Field9527/ac880-fall-monitor/board_runtime/README.md

# AC880 摔倒监护与手势控制试运行

./run.sh 手动启动；./run.sh status 查看；./run.sh stop 安全停止。
run_home.sh 等同 run.sh；run_fall.sh 仅 HDMI。不开机自启。
OV5640 720p、PL 图像处理、DHT11 与 LED/蜂鸣器控制保留。
HDMI 顶部显示状态与评分，底部显示环境、手势及视频信息；报警采用红色边框，手机回放带有明确标记。
CPU 摔倒分支沿用 v6 权重；小型共享特征复核器判断手部、局部人体等。
张开手掌：全部开灯；握拳：全部关灯；V手势：短鸣0.5秒；停止鸣叫请用网页按钮。
单手完整入镜，保持手势至连续确认；保持不动只执行一次。网页可关闭手势控制。
手机回放模式暂停手势控制；网页手动控制始终可用。手部检测不能直接否决摔倒报警。
网页手机回放模式可手动设置输入方向；不会自动猜测重力方向。
重复回归通过不代表现场验收通过。原始训练数据和检查点不包含在运行包中。

## 拨码切换

SW0 是用户拨码开关第 0 位：向下（0）只运行摔倒识别，暂停手势；向上（1）只运行手势识别，暂停摔倒报警。切换时先消抖 150 毫秒，再排空旧任务并丢弃旧结果；LED 当前亮灭保持，旧报警或手势短鸣结束。环境采集、HDMI、视频与网页手动控制继续工作。不要改动启动方式选择开关。

本功能需要完整配套的 bit/hwh 与程序；接口缺失时识别保持暂停，并提示更新 FPGA 配置。HDMI 与网页均显示当前模式。手势模式不能用于同时监护摔倒，摔倒模式也不保证零误报。
