Field9527/ac880-fall-monitor/THIRD_PARTY_NOTICES.md

# 许可与来源

项目源码、供应商硬件代码、依赖库、模型和数据分别遵循对应文件中的版权、许可与使用条件。本仓库的公开展示不改变这些条件，不对全部内容统一重新授权。

| 组成 | 来源与条件 |
| --- | --- |
| NCNN | Tencent NCNN，BSD 3-Clause，完整声明见 `board_runtime/assets/licenses/ncnn-LICENSE.txt` |
| 掌部与关键点模型 | OpenCV Zoo，Apache-2.0；原始模型哈希见 `board_runtime/assets/models/gestures/source_manifest.json` |
| Fashion-MNIST | Zalando Research，MIT；声明见 `ac880_fall/ml/fashion-mnist-LICENSE.txt` |
| CAUCAFall v4 | DOI `10.17632/7w7fccy7ky.4`，CC BY 4.0 |
| UR Fall | 按作者说明采用 CC BY-NC-SA 4.0，用于非商业学术研究 |
| FreiHAND | 按其研究和非商业使用条件用于辅助区域监督，不包含原始图像 |
| 硬件模块 | 保留 RTL 文件中的供应商、作者及版权说明 |
| HDMI 字体 | DejaVu Sans 的 ASCII 子集，保留字体许可，见 `board_runtime/assets/licenses/DejaVu-LICENSE.txt` |

数据来源、划分边界和使用方式见 [数据来源记录](board_runtime/assets/DATA_SOURCES.md) 与 [训练说明](ac880_fall/ml/README.md)。原始数据集、相机原图和用户反馈画面不包含在仓库中。配套模型用于本项目研究与演示，使用时还应遵守相关模型及数据的条件。
