Field9527/ac880-fall-monitor/board_runtime/app/dual_inference.py

"""按识别模式处理最新帧，各最多一个在途任务。"""

from concurrent.futures import ThreadPoolExecutor
import os
from fall_lite import LatestFrameInference
from hand_region_review import review_hand_region


class ConcurrentGestureInference(LatestFrameInference):
    def __init__(self, detector, timeout_s=3.0, partition_cpus=False):
        self.owner_affinity = None
        cpus = []
        if partition_cpus and hasattr(os, "sched_getaffinity") and hasattr(os, "sched_setaffinity"):
            cpus = sorted(os.sched_getaffinity(0))
        if len(cpus) >= 2:
            self.owner_affinity = set(cpus)
            owner_cpu, hand_cpu = cpus[:2]
            # Linux 的 pid=0 仅设置当前线程。
            os.sched_setaffinity(0, {owner_cpu})
            super().__init__(
                detector, timeout_s, worker_initializer=lambda: os.sched_setaffinity(0, {owner_cpu})
            )
            self.hand_pool = ThreadPoolExecutor(
                max_workers=1, initializer=lambda: os.sched_setaffinity(0, {hand_cpu})
            )
        else:
            super().__init__(detector, timeout_s)
            self.hand_pool = ThreadPoolExecutor(max_workers=1)
        self.hand_future = None
        self.hand_submitted_at = None
        self.hand_completed = 0
        self.hand_observation = {}
        self.fall_epoch = self.hand_task_epoch = self.active_generation = None

    def poll(self, frame, now):
        # 空闲任务才取得自有快照，避免持有 DMA 视图。
        owned = []

        def source():
            if not owned:
                owned.append(frame() if callable(frame) else frame)
            return owned[0]

        options = self.detector.semantic_options.configuration
        generation = options["generation"]
        mode = options["recognition_mode"]
        fall_enabled = mode in ("both", "fall")
        enabled = mode in ("both", "gesture") and self.detector.gestures_enabled()
        if generation != self.active_generation:
            self.active_generation = generation
            self.hand_observation = {}
            self.observation = dict(
                ready=mode == "gesture",
                bbox=None,
                score=0.0,
                area=0,
                detections=[],
                objects=[],
                reviewed_candidates=[],
                fall_fresh=False,
                reason="model_mode_switch",
                semantic_generation=generation,
                monitor_mode=options["mode"],
            )
        fresh = False
        if self.future is not None:
            if self.future.done():
                observation = self.future.result()
                self.future = None
                self.completed += 1
                if fall_enabled and self.fall_epoch == generation:
                    observation.setdefault("source_monotonic", self.submitted_at)
                    self.observation = observation
                    fresh = True
                    self.fall_completed += int(observation.get("fall_fresh", True))
            elif now - self.submitted_at > self.timeout_s:
                raise TimeoutError("Fall inference exceeded %.1f seconds" % self.timeout_s)
        if self.hand_future is not None:
            if self.hand_future.done():
                hand = self.hand_future.result()
                self.hand_future = None
                if enabled and self.hand_task_epoch == (generation, options["gesture_generation"]):
                    self.hand_observation = hand
                    self.hand_completed += 1
            elif now - self.hand_submitted_at > self.timeout_s:
                raise TimeoutError("Hand inference exceeded %.1f seconds" % self.timeout_s)
        if not enabled:
            self.hand_observation = {}
        # 互斥模式先排空另一任务；不能取消正在使用模型的线程。
        if fall_enabled and self.future is None and (mode == "both" or self.hand_future is None):
            self.submitted_at, self.fall_epoch = now, generation
            self.future = self.pool.submit(self.detector.process, source(), now)
        interval = self.detector.hand_interval_s
        if (
            enabled
            and self.hand_future is None
            and (mode == "both" or self.future is None)
            and (self.hand_submitted_at is None or now - self.hand_submitted_at >= interval)
        ):
            self.hand_submitted_at = now
            self.hand_task_epoch = (generation, options["gesture_generation"])
            self.hand_future = self.hand_pool.submit(self.detector.process_hand, source(), now)
        result = dict(self.observation)
        hand = self.hand_observation
        if (
            enabled
            and hand.get("hand_semantic_generation") == options["generation"]
            and hand.get("gesture_generation") == options["gesture_generation"]
        ):
            result.update(hand)
        else:
            result.update(
                hand=None,
                hand_sampled_at=None,
                hand_sequence=0,
                gesture_generation=options["gesture_generation"],
            )
        if fresh:
            result = review_hand_region(result, now)
            self.observation = dict(result)
        result["recognition_mode"] = mode
        # 手势任务完成不能刷新旧摔倒证据的时间。
        return result, fresh

    def close(self):
        self.hand_pool.shutdown(wait=True)
        super().close()
        if self.owner_affinity is not None:
            os.sched_setaffinity(0, self.owner_affinity)
