Field9527/ac880-fall-monitor/(commit log)

2026-10-30 发布跌倒识别与环境智控系统
    [hand_nchw.ncnn.param, palm_nchw.ncnn.param, shared_semantic.ncnn.param]
2026-10-30 精简当前工程并完善 HDMI 监护界面
2026-10-30 网页独立绘制清晰文字并共享视频网关
2026-10-31 使用 SW0 互斥切换摔倒与手势识别
